Tecnomobele-FGA/Computador-de-bordo/README.md

# OBC - Computador de bordo 

`Documentos/GitHub/Computador-de-bordo`

[github.com/Tecnomobele-FGA/Computador-de-bordo](https://github.com/Tecnomobele-FGA/Computador-de-bordo)

# 1. Apresentação

Escolheu-se para o computador de bordo do BRElétrico o minicomputador *Beagle Bone*. A sua escolha se baseou no fato de ter uma arquitetura apropriado para sistemas embarcadas baseado em num ARM, ter além do processador principal, dois *Programmable Real-time Unit (PRU)* que podem ser usados para alguma necessidade de processamento dedicado e dois controladores CAN já incorporados na sua placa.

Há diversas versões do Beagle Bone. Um dos mais populares é o *Beagle Bone Black (BBB)* que foi a primeira versão usado neste desenvolvimento.

BBB tem uma interface HDMI, porta ethernet, porta USB e já vem com Linux embarcada e toda estrutura de software para habilita-lo como servidor com toda funcionalidade TCP-IP internet inerente do Linux. 

A figura a seguir mostra o diagrama do bloco do computador de bordo com display HDMI no painel do veículo e as redes  CAN ligado aos módulos. 

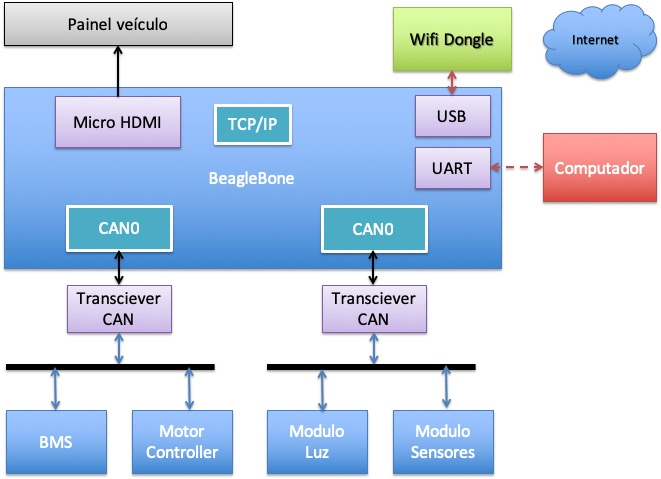
[picture p1: figuras/Diagrama_BBB_can.jpg]


Entretanto, há uma versão mais nova que foi lançada recentemente que é mais compacto (e barato). O PocketBeagle, tem toda a funcionalidade do BBB, mas diversos conectores físicos dos interfaces da BBB foram retiradas e também foi retidada a interface HDMI. 

```
$uname -a
Linux beaglebone 4.19.94-ti-r50 #1buster SMP PREEMPT Mon Aug 24 23:03:55 UTC 2020 armv7l GNU/Linux
```

Para implementar a proposta foi necessário ligar um transciever CAN para  adequar os sinais cmos do Beagle ao padrão do barramento CAN. Este módulo é alimentado com 3.3V podendo ser diretamente ligado no barramento de expansão do Beagle.

O Beagle funcionará como ponte entre as duas redes CAN e a rede TCP-IP. A partir da rede TCP-IP pode-se ter acesso ao Beagle permitindo a sua monitoração remoto ou re-programação.

A primeira rede Can (Can0) estará ligado aos subsistemas críticos do veículo elétrica, fazendo o monitoramento do banco do bateria, o motor de tração e outros subsistemas que precisam comunicar entre se neste barramento mas rápido. 

A segunda rede (Can1) permitirá a comunicação entre o modulo de medição de velocidade e temperatura, o módulo de sinalização e luzes e demais módulos que não são críticos ao funcionamento do veículo. A comunicação destes útimo barramento pode ter uma velocidade menor que o primeiro.

A implementação deste sistema foi feito com um PocketBeagle e um modulo conversor CAN baseado no transciever SN65HVD230, conforme mostrado na foto a seguir:

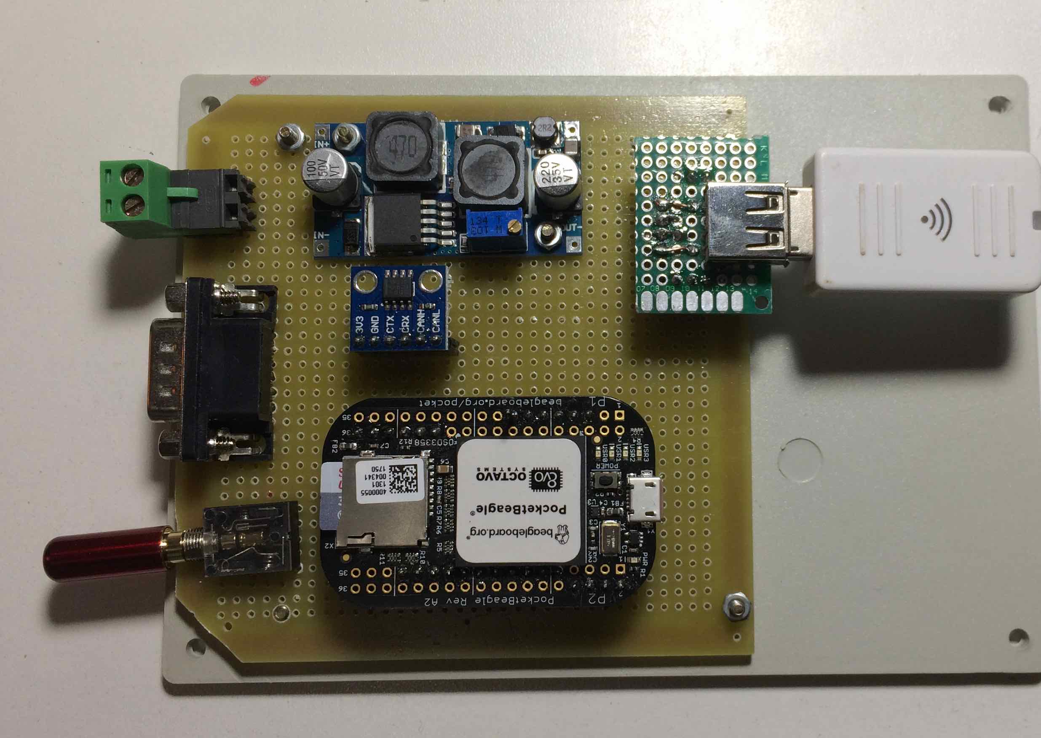
[picture p2: fotos/pocketbeagle_can.jpg]


O Pocket Beagle foi montado numa placa com transciever CAN, conversor CC/CC 12/5 volts, Wifi USB Dongle, e acesso para o serial UART.  

A tabela a seguir mostra a proposta de uso dos periféricos do Pocket Beagle. 

| Beagle  | uso | pinos | Situação |
|:---:|:---:|:-----:|:---:|
| CAN 0 | Barramento CAN  | P1 - 26, 28 | Implementado |
| CAN 1 | ainda nao ligado fisicamente  | P2 - 9,8 | Ainda não |
| USB | WiFi Dongle | P1 - 5,7,9,11,13,15 | Implementado |
| UART 0  | Acesso ao Beagle pelo serial com terminal | P1 - 30, 32 | Implementado |
| UART 2  | GSM SIM800L | P1 - 8,10,12 | Ainda não |
| UART 4  | Serial GPS | P2 - 5,7 | implementado |
| Battery | Litium 18650 | P2 - 14,16 | Implementado | 
| GPIO | Chaves para GND | P2 - 2,4 | Montada | 

# 2. Configurando o PocketBeagle

## 2.1 Acessando o PocketBealge

O primeiro passo é configurar o hardware do PocketBeagle para a proposta.

Os pinos no barramento de acesso do PocketBeagle podem ser configurados para dar acesso a várias funcionalidades do computador. 

A dificuldade consiste no fato de o Beagle ter um sistemática de mapeamento de hardware no sistema operacional Linux específica, diferente dos computadores convencionais. O Beagle é um computador numa única placa que usa o processador com arquitetura ARM. Por conta dos inúmeros sistemas baseados no arquitetura ARM que surgiram para sistemas embarcadas, houve uma modificação no Kernel do Linux para dar conta a especificidades destes sistemas.

### 2.1.1 Acessando o Beagle pelo Serial UART

Uma maneira simples de acessar o Beagle sem ter que usar monitor teclado ou rede é pela porta UART0 do Beagle.
Essa porta já vem habilitado para você entrar por meio de um programa emulador de terminal. 
Os pinos do Pocket Beagle que permitem este acesso são dados na tabela a seguir. 

| Beagle  | con | pino | UART | pino |
|:---:|:---:|:----:|:----:|:----:|
| gnd | P1  | 16 | GND  | |
| tx uart0| P1  | 30 | rx | |
| rx uart0| P2  | 32 | tx | |

O nível de tensão do UART é de 3.3 volts, e pode se acessar com um conversor USB- Serial TTL. 

O programa de emulador de terminal tem que estar configurado com a porta serial em 115kbps, 8N1.

A foto a seguir mostra o conversor SERIAL USB-TTL que foi usado para ligar o Beagle a porta USB de computador para ter acesso via terminal ao Beagle.
 
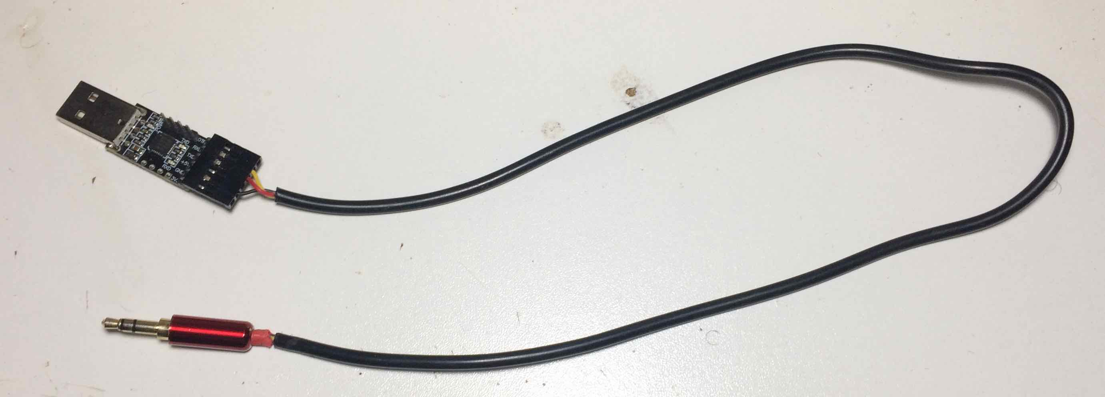
[picture p3: fotos/Serial_interface.jpg]


### 2.1.2 Acessando o Beagle pelo USB ou pela rede

O PocketBeagle pode ser accessado na USB pelo comando:
 
`ssh debian@192.168.6.2`  ou `ssh debian@beaglebone.local` 

e a senha padrão do Beagle é `temppwd` 

### 2.1.3 Configurado Cloud9 IDE 
Uma opção de acessar o Beagle é usando o Cloud9 IDE. Essa opção é habilitado quando ligar o Beagel pela porta USB ao computador, e pode ser acessado por meio de um browser pelo endereço `http://192.162.6.2 do computador (mac os ou linux).

A interface do Cloud9 é muito bom e tem diversos programas exemplos direcionado para o Beagle. 

Uma limitação é que ele aponto para o endereço `/var/lib/clouds` e não para a nossa area de trabalho no Debian.

Para mudar isso tem um tutorial no [link](https://paulbupejr.com/change-cloud9-workspace/)

O procedimento consiste em criar um override do `systemctl edit cloud9` e colocar no novo arquivo criado o seguinte conteudo 

```
[Service]
ExecStart=
ExecStart=/usr/bin/nodejs server.js --packed -w /home/debian/src
```

Depois precisa reiniciar o servico 

```
systemctl daemon-reload
systemctl restart cloud9
```

Ao acessar o IDE do Cloud9 no browser terá como diretório atual o 
```
/home/debian/src
```

## 2.2 Configurando a interface CAN

No sistema operacional Linux  convencional as especificidades do hardware são de certa forma incorporadas no Kernel, mas este sistemática se mostrou impraticável com as placas ARM. Por isso foi introduzido a estrutura de Device Tree para que o computador Beagle saiba qual hardware e periféricos estão fisicamente instalados na placa. Veja o artigo de Mateus Gagliardi: Introdução ao uso de Device Tree e Device Tree Overlay em Sistemas Linux Embarcado. 2015. <https://www.embarcados.com.br/device-tree-linux-embarcado/>

No caso do Beagle essa estrutura de Device Tree tem que dar conta para definir quais pinos serão usados do hardware, pois Beagle tem portas genéricas para entrada e saída de dados (GPIO), uma porta analógica (ADC), PWM, UART, SPI e I2C pinos, e estes pinos podem ser configurados para diversos usos. No nosso caso específico, as duas controladoras CAN usam alguns dos pinos da SPI e do I2C como entrada e saída dos sinais CAN. 

Este roteiro é uma adaptação da configuração do BBB no artigo no [https://www.beyondlogic.org/adding-can-to-the-beaglebone-black/](https://www.beyondlogic.org/adding-can-to-the-beaglebone-black/) para o PocketBeagle.

Nos releases dos kernels mais novos a configuração do pinos é melhor documentos. Para ver a versão do kernal pode executar o comando: 

`$ uname --a`

```
Linux beaglebone 4.19.94-ti-r42 #1buster SMP PREEMPT Tue Mar 31 19:38:29 UTC 2020 armv7l GNU/Linux
```

Para verificar se de fato a Can bus está mapeado no kernel pode-se executar o comando 
`$ dmesg | grep can`

A resposta tem que ser algo do tipo: 

```
[    1.047544] c_can_platform 481cc000.can: c_can_platform device registered (regs=5e6dc592, irq=39)
[    1.049113] c_can_platform 481d0000.can: c_can_platform device registered (regs=e2b987c8, irq=40)
[    1.186345] can: controller area network core (rev 20170425 abi 9)
```

O próximo passo é configur as duas portas can0 e can1. 
A figura a seguir mostra os conectores P1 e P2 com as diversas opções dos pinos.

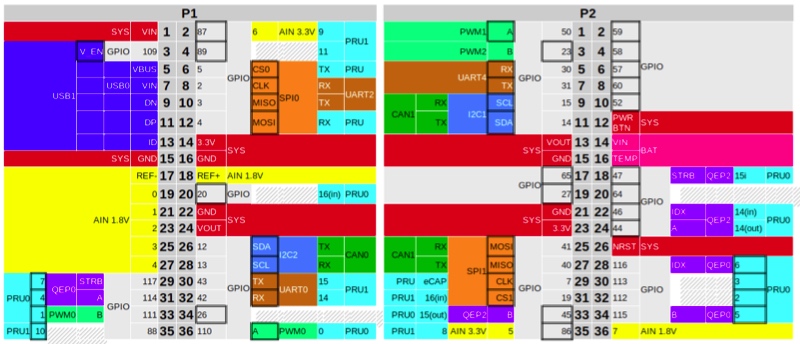
[picture p4: figuras/conector_pocket.jpg]


A interface CAN0 pode ser ligado nos pino 26 e 28 do conector P1. 
Nota-se que a interface CAN1 pode ser ligado nos pinos 9,10 ou 25,27.
Escolheu-se ligar os pinos 26 e 28 do P1 para can0 e 26 e 27 do P2 para can1

| Beagle  | con | pino | transciever | pino |
|:---:|:---:|:----:|:---:|:----:|
| gnd | P2  | 21 | GND | 2 |
| 3.3v | P2  | 23 | 3V3 | 1 | 
| can1 rx | P2  | 25 | CRX | U1-4 |
| can1 tx | P2  | 27 | CTX | U1-3 |
| can0 tx | P1  | 26 | CTX | U2-3 |
| can0 rx | P1  | 28 | CRX | U2-4 | 

Há um programa de configuração de pinos que permite escolher a funcionalidade do pino e ver seu atual uso.
Por exemplo o seguinte comando lista todas as opções disponíveis para o pino P2.5:
 
`config-pin -l P2.25`

```
Available modes for P2_25 are: default gpio gpio_pu gpio_pd gpio_input spi spi_cs uart can i2c
``` 

Para configurar o pino para acessar a interface can:

`config-pin P2.27 can`

Para finalizar o processe de configuração do hardware temos que iniciar a interface CAN com o seguinte comando: 

` sudo /sbin/ip link set can1 up type can bitrate 500000`

Com isso pode se verificar o status da interface can com os comandos normais de rede do linux que deve mostrar a nova interface can e todos os outros interfaces de comunicação do sistema.

`ifconfig`

Para automatizar o processo de ativação do Can bus no boot ainda falta descobrir como configurar os pinos como interface can durante o boot. 
Uma opção é de colocar dentro do `crontab` uma sequencia de scripts que serão executados durante o boot.  

script de configuração do CAN no arquivo `code/can0_can1_start.sh`

```
#!/bin/bash
echo "Iniciando as configuracoeas dos pinos para a rede CAN..."

config-pin P1.26 can
config-pin P1.28 can
sudo /sbin/ip link set can0 up type can bitrate 250000

config-pin P2.25 can
config-pin P2.27 can
sudo /sbin/ip link set can1 up type can bitrate 250000

echo "Pinos de CAN0 e CAN1 configurados!..."
```

Com isso conseguimos resolver a parte mais difícil até o presente momento que foi a configuração do Beagle para ativar os dois controladores CAN, habilitar o hardware de interfaceamento com os transcievers CAN e configurar a porta de comunicação no linux para conversar com os controladores.

Para testar se os canais CAN estão funcionando, pode fazer o teste com o loopback 
`sudo /sbin/ip link set can0 up type can bitrate 250000 loopback on`

### 2.2.1 Ligando CAN no DB9

Tem dois padrões de ligação do conector CAN no DB9. 
Um padrão é compativel com a placa Arduino CAN Shield da Sparkfun e o cabo DB9-OBDII que a acompanha.

O Cabo tem a seguinte pinagem  OBDII para DB9 Femea.

| Pin Description | OBDII | DB9 |
|:---|:-----:|:---:|
| J1850 BUS+ |  2 | 7 |
| Chassis Ground |  4 | 2 |
| Signal Ground |  5 | 1 |
| CAN High J-2284 |  6 | 3 |
| ISO 9141-2 K Line	|  7 | 4 |
| J1850 BUS- | 10 | 6 |
| CAN Low J-2284 | 14 | 5 |
| ISO 9141-2 L Line	| 15 | 8 |
| Battery Power | 16 | 9 |

[https://www.sparkfun.com/products/10087](https://www.sparkfun.com/products/10087)

Tem que ter cuidado de não ligar o DB9 para uma porta serial RS232 convencional, pois os pinos de GND e TX e RX com tensão +de 12 e -12v vão diratemente no transciever. 

Há um outro padrão de pinagem CAN para DB9, mas eu ainda não descobri de onde que vem esta definição.

Vamos usar este padrão novo, pois o cabo OBDII-DB9 a gente dificilmente vai usar no carro elétrico.

Dessa forma o conector CAN do Beagle com um DB9 macho terá os seguintes pinos: 

| Transciever | DB9 | 
|:---:|:---:|
| CANL | 2 |
| CANH | 7 | 
| GND | 3 |

### 2.2.2 Testando com can-utils

O sistema operacional Linux embarcada no BBB já vem com pacote SocketCan ou can-utils de ferramentas para trabalhar com a rede de comunicação CAN.
 
Este pacote de ferramentas e utilitários permite visualizar, registrar e gerar tráfego de dados do barramento CAN, além de permitir acesso ao barramento CAN via IP sockets entre vários outros funcionalidades. <https://github.com/linux-can/can-utils>

O utiltário candump do SocketCan permite visualizar os dados do barramento de comunicação.

Com o programa cangen é possivel gerar uma saída aleatorio numa porta can. 
Para testar a rede can executa num terminal :

```
debian@beaglebone:~$ cangen can0
```

Num outro terminal executa 

```
debian@beaglebone:~$ candump any -x 
  can0  RX - -  6B9   [8]  EB 3F 68 35 C9 1B DE 56
  can1  TX - -  6B9   [8]  EB 3F 68 35 C9 1B DE 56
  can0  RX - -  37A   [8]  76 4A DF 7A 42 74 85 5C
  can1  TX - -  37A   [8]  76 4A DF 7A 42 74 85 5C
  can0  RX - -  0EA   [1]  DF
  can1  TX - -  0EA   [1]  DF
  can0  RX - -  69D   [8]  0F E2 C0 10 A8 34 8E 2B
  can1  TX - -  69D   [8]  0F E2 C0 10 A8 34 8E 2B
  can0  RX - -  5EF   [1]  1D
  can1  TX - -  5EF   [1]  1D
```

Há uma vasta documentação técnica sobre o uso do SocketCan em sistemas operacionais Linux acessando a porta CAN a partir de programas desenvolvido em C/C++ ou Python.

## 2.3. Ligando wifi no Beagle

Para facilitar o desenvolvimento no Pocket Beagle é necessário colocar o Beagle diretamente na internet sem usar a porta USB do computador hospedeiro. 

Para configurar o WiFi Dongle foi usado o `connmanctl` conforme mostrado na figura a seguir.

| Beagle  | con | pino | USB | pino |
|:---:|:---:|:----:|:---:|:----:|
| Vbus | P1  | 5 | Vcc | 1 |
| Vin | P1  | 7 | Vcc | 1 | 
| DN | P1  | 9 | | 2 |
| DP | P1  | 11 | | 3 |
| ID | P1  | 13 | GND | 4 |
| GND | P1  | 15 | GND | 4 |

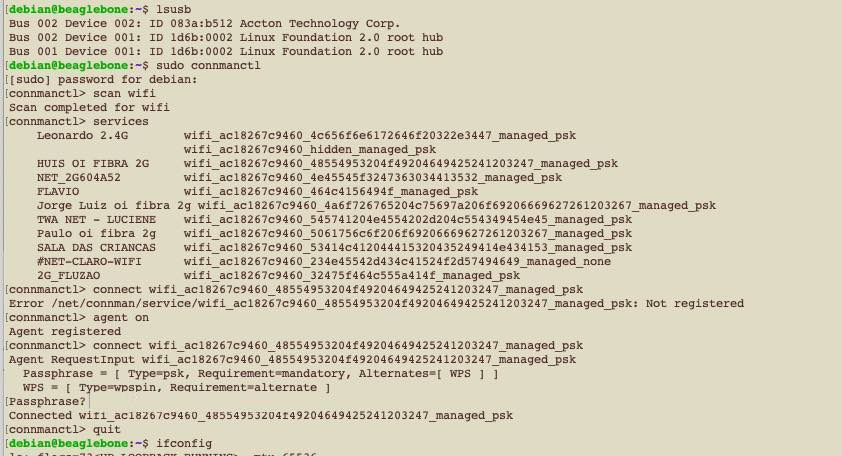
[picture p5: figuras/Beagle_wifi_config.jpg]


O funcionamento do USB WiFi Dongle ficou meio devagar com o tempo. 
Quando logo pelo ssh ele demora alguns segundos para processar os comandos. 
Não sei se foi a inclusão de outras portas seriais ou se há a necessidade de desligar as outras portas USB.

Aparentemente o WiFi dongle está esquentando além do normal. Pode ser um problema neste modelo de dongle que está dos antigos.

### 2.3.1. Endereço IP fixo no wifi
Para manter um IP fixo no beagle podemos configurar por meio do `connmanctl` a configuração da rede wifi. 
Na distribuição DEBIAN que estamos usando não temos os arquivos de configuração da rede na pasta `/etc/wpa_supplicant/` como a gente encontre no Raspberry Zero com sua distribuição linux.

No Beagle com Debian, aparentemente as configuracoes estão nos diretórios na pasta `/var/lib/connman/`. 
Cada diretório corresponde a uma das configurações dos wifi já usados no sistema. Neste diretório há o arquivo `settings` com a configuração.

Achie num tutorial na internet uma maneira para configurar este arquivo `settings` para ter um IP Fixo. 

```
IPv4.method=manual                ←Method to be used (in this case manual IP)
IPv4.netmask_prefixlen=24
IPv4.local_address=192.168.0.133  ←Desired IP address
IPv4.gateway=192.168.0.1
Passphrase=<PASS>                 ←Wifi network password
AutoConnect=true
```

Eu ainda não testei, mas vale a pena depois testa-lo e tirar a dificuldade de adivinhar cada vez o endereço IP. 
Entretanto, deve ter uma maneira de fazer isso diretamento usando o `connmanctl`.

## 2.4. Módulo GPS Ublox 7

O módulo GPS tem as seguintes características.

* Alimentação: de 3,3 V à 5 V DC
* Corrente de operação: entre 35 mA e 50 mA
* Comunicação serial/TTL 3.3V
* Antena embutida

| Pino | 	Função no GPS | Ligação Beagle |
|:----:|:---:|:---:|
| 1	 | Vcc | Vcc |
| 2	 | GND | GND |
| 3	| TX out | RX4 pino P2-05 |
| 4	| RX in  | TX4 pino P2-07 |

Detalhamento da comunicação. O formato do Protocolo de comunicação NMEA0183.

* Cada início de mensagem começa com o símbolo cifrão(\$).
* Os próximos 5 caracteres indicam a origem da mensagem, sendo dois para a origem e três para o tipo de mensagem.
* Todos os campos dos dados são delimitados por vírgulas.
* O primeiro caractere do último campo deve ser um asterisco (*).
* O asterisco é seguido de um checksum de dois dígitos em hexadecimal
* A mensagem é terminada com um Nova Linha ( <CR><LF> ou "\n" ).

A figura a seguir mostro o módulo GPS ligado no computador de bordo.

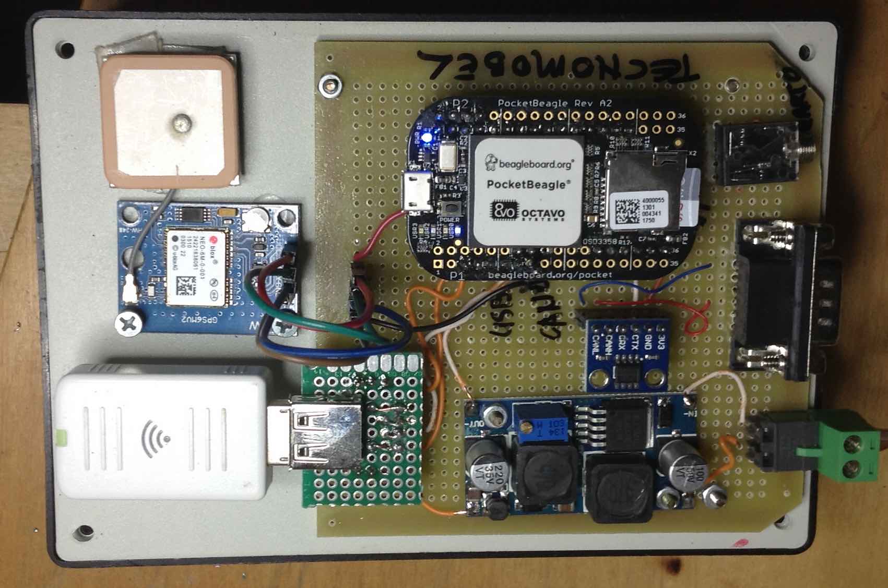
[picture p6: fotos/modulo_GPS.jpg]


Este módulo foi ligado a porta Serial UART 4 do Pocket Beagle.
Para verificar se as portas serias estão devidamente instaladas e habilitados na versão do sistema operacional do Pocket Beagle, podemos verificar isso com o seguinte comando:

```
debian@beaglebone:~$ dmesg | grep tty
[    0.000000] Kernel command line: console=ttyO0,115200n8 root=/dev/mmcblk0p1 ro rootfstype=ext4 rootwait coherent_pool=1M net.ifnames=0 lpj=1990656 rng_core.default_quality=100 quiet
[    0.001786] WARNING: Your 'console=ttyO0' has been replaced by 'ttyS0'
[    1.201568] 44e09000.serial: ttyS0 at MMIO 0x44e09000 (irq = 30, base_baud = 3000000) is a 8250
[    1.211685] console [ttyS0] enabled
[    1.212940] 48022000.serial: ttyS1 at MMIO 0x48022000 (irq = 31, base_baud = 3000000) is a 8250
[    1.213937] 48024000.serial: ttyS2 at MMIO 0x48024000 (irq = 32, base_baud = 3000000) is a 8250
[    1.214879] 481a8000.serial: ttyS4 at MMIO 0x481a8000 (irq = 33, base_baud = 3000000) is a 8250
debian@beaglebone:~$ 
```

Conforme a listagem podemos confirmar que a porta ttyS4 está instalada nessa versão do software. 
Entretanto é necessária habiltar os pinos do UART 4 do PocketBeagle por meio do comando config-pin

```
debian@beaglebone:~$ config-pin -l P2_05

Available modes for P2_05 are: default gpio gpio_pu gpio_pd gpio_input uart
debian@beaglebone:~$ config-pin P2_05 uart
debian@beaglebone:~$ config-pin P2_07 uart

```

Para testar se o GPS está comunicando com o PocketBeagle pode-se usar por exemplo o programa Minicom, configura-lo para ttyS4, 9600 bps, 8N1, e dessa forma deve aparecer a seguinte tela, onde a cada segundo a informação do GPS é atualizada. 

```
Welcome to minicom 2.7.1

OPTIONS: I18n 
Compiled on May  6 2018, 10:36:56.
Port /dev/ttyS4, 12:19:54

Press CTRL-A Z for help on special keys

$GPRMC,,V,,,,,,,,,,N*53
$GPVTG,,,,,,,,,N*30
$GPGGA,,,,,,0,00,99.99,,,,,,*48
$GPGSA,A,1,,,,,,,,,,,,,99.99,99.99,99.99*30
$GPGSV,1,1,01,05,,,23*7C
$GPGLL,,,,,,V,N*64
$GPRMC,,V,,,,,,,,,,N*53
$GPVTG,,,,,,,,,N*30
$GPGGA,,,,,,0,00,99.99,,,,,,*48
$GPGSA,A,1,,,,,,,,,,,,,99.99,99.99,99.99*30
$GPGSV,1,1,02,05,,,23,06,,,24*7F

```
### 2.4.1 Datalogger para registrar rota 
O programa para registra os dados do GPS e (ou a rota ou percurso) do veículo a uma amostragem de 1 hz está no [subdiretório deste repositório](./Datalogger_Scada/README.md).

## 2.5. GSM SIM800L  

Módulo GPRS GSM SIM800L 

Especificações:

* CI SIM800L;
* Frequências: EGSM900, DCS1800, GSM850, PCS1900;
* GPRS Data Downlink: 85.6 kbps (máximo);
* GPRS Data Uplink: 85.6 kbps (máximo);
* Suporte PAP (password authentication protocol) para conexões PPP;
* Protocolo TCP/IP embutido;
* Serial: 1200 bps à 115.200 bps;
* Temperatura de operação: -40 à 85°C;
* Dimensões: 21 x 15 x 3,2mm.

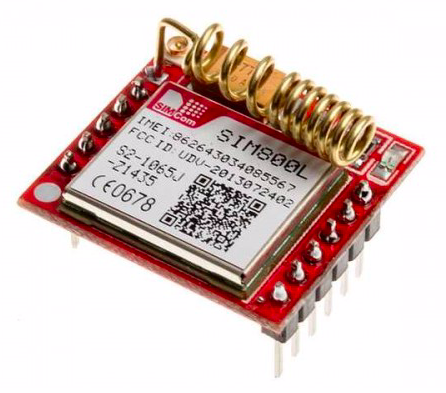
[picture p7: fotos/GSM_sim80L.png]


| Pino | 	Nome do Pino |Função | Ligação Beagle | Pino |
|:----:|:---:|:---:|:---:|:----|
| 1 | Vcc | Alimentação 3.3v  | 3.3V do LM317 | null |
| 2	 | RST | Reset | GPIO | P1-12 |
| 3	 | RxD | Entrada - receptor uart  | TxD UART 2 |P1-08|
| 4	 | TxD | Saída - transmissor uart | RxD UART 2 |P1-10|
| 5	 | GND | comun  | GND | GND |

Configurando os pinos do Pocket Beagle para habilitar UART 2 usando 

```
$ config-pin -l P1.08
$ config-pin P1.08 uart
$ config-pin P1.10 uart
```

[datasheet do SIM800L](https://cdn.awsli.com.br/78/78150/arquivos/sim800l-datasheet.pdf)

Os comandos AT para usar o GPRS para mandar dados via internet são:

[exemplo no tutorial](https://www.youtube.com/watch?v=7GtfhTVDIc0)

```
AT+SAPBR=3,1,"APN","CMNET"
AT+SAPBR=1,1
AT+SAPBR=2,1
AT+HTTPINIT
AT+HTTPPARA="CID",1
AT+HTTPPARA="URL","http://164.41.92.20:8080/ScadaBR/httpds?bat_litium_ups=3.7"
AT+HTTPACTION=0
AT+HTTPREAD
AT+HTTPTERM
AT+SAPBR=0,1

```

A primeira vez quando mandou o comando o servidor ScadaBR recebeu os dados e consegui mostrar o valor encaminhado. 
Na segunda vez deu o servidor retornou um erro 601. Falta analisar todos os comandos AT do GPRS e avaliar essa funcionalidade do modem.

## 2.6. Bateria Litium 18650

O Pocket Beagle tem um circuito de carga linear e gerenciamento de bateria de integrado. O *Linear charge and power path management system* do Pocket Beagle é baseado no por um circuito de alimentação da bateria, um sensor de temperatura que permite a entrada de um termistor de 10K e o circuito está integrada com o botão de reset do pocket beagle.

A bateria Litium 18650 foi ligado aos pinos P2.14 e GND junto com um resistor no pino P2.16  e GND para simular a função do termistor. 

Não houve a necessadade de configuração específico da função de UPS. O funcionamento é automática. 

Essa bateria de 3.800 mAh é capaz de segurar o funcionameno do Beagle durante algumas horas.

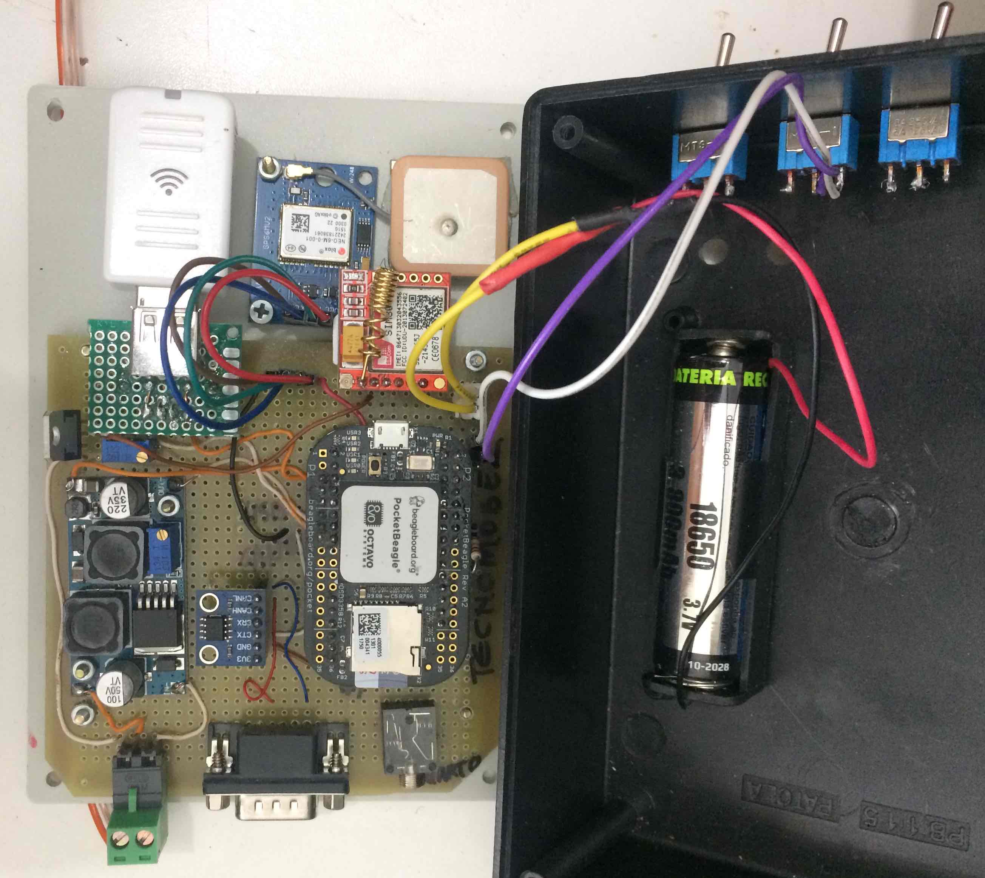
[picture p8: fotos/OBC_completo.jpg]


A entrada de P2.14 permite uma tensão de entrada de 3,7V de uma bateria Litium e o Pocket Beagle gera internamente 3.3 V para seu funcionamento. 

As saidas 3.3V do Pocket também são alimentados, então por exemplo os módulos GPS e CAN funcionam normalmente com essa bateria.

Quando o OBC está sendo alimentado com 5V, o bateria é carregada automáticamente e quando a tensão de 5V é retirada a bateria assume automaticamente a alimentação do Pocket Beagle. 

Para desligar o OBC deve-se então apertar o botão de reset. 

Quando se liga o o Pocket Beagle à bateria, o sistema só inicia o boot quando apertar o botão de reset. 

Deve ter alguma funcionalidade de monitorar a tensão da bateria já embutido no Linux, mas eu ainda não descobri os detalhes do seu acesso e funcionamento.

## 2.7. Display OLED 

Para facilitar a inspecção de funcionamento do Beagle foi colocado um display Oled de 128x32 SSD1306. 
Como este display tem uma interface i2c e é alimentado com 3.3Volts a montagem pode ser diretamente na porta i2c 1 do Beagle (Testamos com o pocket beagle - falta testar no BBB).

A foto a seguir mostra a montagem.

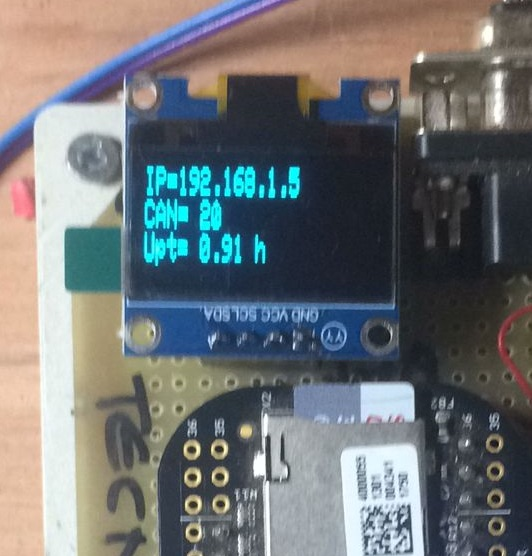
[picture p9: fotos/Foto_Oled.jpg]
 

Para configurar os pinos do i2c configuramos os mesmos como o aplicativa config-pin conforme mostrada a seguir.

```
$ config-pin P2.09 i2c
$ config-pin P2.11 i2c
```

O programa para ler o endereço IP e mostrar no display em python é:

```
from board import SCL, SDA
import busio
import adafruit_ssd1306
import netifaces

font='/home/debian/src/Oled/font5x8.bin'

i2c = busio.I2C(SCL, SDA)
display = adafruit_ssd1306.SSD1306_I2C(128, 32, i2c)

display.fill(0)
display.show()
display.rotate(180)

lista=netifaces.interfaces()
if 'wlan0' not in lista:
     display.text("IP= sem wlan0",1, 1, 1,  font_name=font, size=1)
else: 
     ad=netifaces.ifaddresses('wlan0')
     xx=ad[netifaces.AF_INET]
     d=xx[0]
     ip=d['addr']
     display.text("IP="+ip,1, 1, 1,  font_name=font, size=1)

```

O arquivo com o fonte `fontxx8.bin` achei depois de uma busca na internet.
 
O desafio agora é fazer com que este programa em python seja chamada no boot para mostrar o endereço internet atualizada.

Tentamos fazer isso com `crontab`, mas não funcionou de forma satisfatório. Pesquisamos e descartamos também a opção de usar o `init.d` e vamos agora testar com `systemd` baseado nestes links 

[https://tecadmin.net/setup-autorun-python-script-using-systemd/](https://tecadmin.net/setup-autorun-python-script-using-systemd/)

[https://blog.merzlabs.com/posts/python-autostart-systemd/](https://blog.merzlabs.com/posts/python-autostart-systemd/)

Quando criamos um service no `/lib/systemd/system/oled.services` e chamamos o script em python surgiu um problema na importação do python com `import adafruit_ssd1306` 
O script em python funcionou normalmente, mas a sua chamada pelo `systemctl` deu este erro. 

Essa falha foi resolvido colocando no `oled.service` o usuário e grupo.

```
debian@beaglebone:~$ cat /lib/systemd/system/oled.service 
[Unit]
Description=Oled_Display
After=multi-user.target

[Service]
Type=simple
ExecStart=/usr/bin/python3 /home/debian/src/Oled/oled.py
User=debian
Group=debian

[Install]
WantedBy=multi-user.target

```

# 3. Comunicação no barramento CAN - Camadas superiores

O computador de bordo tem que monitorar o controlador do motor elétrico e o BMS no barramento CAN de alta prioridade (velocidade).

O computador de bordo (OBC) tem que ser flexivel o bastante para se comunicar com diversos modelos de controladores de motores elétricos e BMS.  

No caso do BRElétrico, temos um motor de CC brushless do fabricante Guandong que tem uma interface CAN. A documentação deste controlador e motor não é dos melhores, mas pelo menos temos a especificação do protocolo CAN usado pelo controlador e indica que usa o protocolo J1939 nas camadas superiorers.

No projeto da conversão da VAN vamos usar o CVW500 da WEG que também tem uma interface CAN e implementa o protocolo CANOPEN.

Vamos implementar os dois protocolos e testar. O J1939 vai ser implementado para o BREletrico e o CANOPEN para a VAN. 
O J1939 tem a vantagem de ser específico para aplicações de mobilidade. 

## 3.1. Protocolo J1939

O protocolo J1939 em termos gerais define as mensagens que vão transitar no barramento, para onde eles vão, as prioridades das mensagens e frequencia com que determinadas mensagens são disponibilizados no barramento.

Dessa foram, o computador de bordo só precisa monitorar o barramento e usar as mensagens que lhe interessa para tomar determinada ação e colocar mensagens com as suas demandas ou ações no barramento de volta. 

Por exemplo: O protocolo J1939 implementado pelo controlador do motor elétrico manda a cada 40ms informação com a tensão e corrente do motor. O BMS manda também em tempos regulares o estado da bateria, indicando quanto de energia ainda tem disponível. O módulo de instrumentação manda a cada 100ms a informação da velocidade do veículo. Com estes dados, o OBC computador de bordo pode calcular por exemplo qual automia em Km, mantendo o mesmo padrão de direção e mostrar essa informação para o condutor.

### 3.1.1. Estrutura do J1939

O J1939 aproveita o identificador do 29 bits do CAN para passar informações específicas do tipo de comunicação. 

A estrutura de bits da identificação tem o seguinte formato.

| priority | Extendes data page | data page | PDU Format | PDU Specific | source adddres |
|:---:|:-----:|:----:|---|---|---|
| 3 bits | 1 bit | 1bit | 8 bits | 8 bits | 8 bits |

Os campos PDU Format e PDU Specific construem o valor que será atribuído ao Parameter Group Number PGN da mensagem e também definem o modo como as mensagens são endereçadas no barramento.

| PDU Format | descriçao | PDU Specific | 
|:-----:|:----:|:---:|
| 0-0xEF ou 0-239 | transmite para endereco indicado no PDU specific | endereco|
| 0xF0-0xFF ou 240-255 | broadcast | Indice de referencia do Group Extension |  

A formatação do PGN é (PDU format) * 0x100 + PDU specific  

## 3.2. Controlador Motor PM BLDC Guandong

Os parametros do Controlador do motor Brushless CC PM BLDC Guandong são mandados por um CAN frame com as seguintes especificações. O fabricante menciona que os protocolos usados são CAN20.0 e J1939

Bus rate: 250kbps

A taxa de envio é 40 ms mandando 2 mensagens, ou seja uma mensagem a cada 20 ms.
 
O protocolo usa CAN 2.0 com CAN expand frame 29th identifier

A primeira mensagem (*frame*) frame ID code é `0x10 08 8A 9E.` ou `268.995.230`.
Isso é uma mensagem que vai de `8A` para `9E`, pois o campo PDU format `08` é menor que `EF`. Ou seja, o endereço do controlador é `9E`. 

O dados encaminhados na mensagem são os seguintes:

| Location | data name |  explain |
|:---:|:---:|:---:|
| BYTE1 | voltage low byte | 0.1 V/bit offset: -10000 range: 0~500v (o offset tá meio estranho )|
| BYTE2 | voltage high byte |
| BYTE3 | currente low byte | 0.1 A/bit offset: -10000 range -500A~500A |
| BYTE4 | currente high byte  |
| BYTE5 | controller temperature | 1℃/bit offset: 40C limit: 0~100℃ |
| BYTE6 | running state |
| BYTE7 | fault code low byte  |
| BYTE8 | fault code high byte |

O BYTE 6 com o Running status tem o seguinte formato: 

| BIT7 | BIT6 | BIT5 | BIT4 | BIT3 | BIT2 | BIT1 | BIT0 | 
|:----:|:----:|:----:|:----:|:----:|:----:|:----:|:----:|
| reserved | ready for | reserved | reserved | stop | brake | backward | forward|

O código de erro nos BYTES 7 e 8 (*Fault code instruction*) tem os seguintes formatos 

| BIT7 | BIT6 | BIT5 | BIT4 | BIT3 | BIT2 | BIT1 | BIT0 | 
|:----:|:----:|:----:|:----:|:----:|:----:|:----:|:----:|
| 0 | ERR7| ERR6 | ERR5 | ERR4 | ERR3 | ERR2 | ERR1 |
| 75℃ | BMS | over speed | over heating | over voltage | under voltage | over current | IGBT |

A segunda mensagem (*frame ID code*) tem como código de identificação de `0x10 09 8A 9E`  ou `269.060.766`. 
Os dados mostram a operação do motor da seguinte maneira:

| DATA LOCATION | DATA NAME | explain |
|---|---|---|
| BYTE1 | motor speed low byte | 1rpm,  offset： 0, range：0 ～10000 |
| BYTE2 | motor speed high byte | |
| BYTE3 | mileage low byte	| 0.1	kilometer, offset：0, range：0～30000| 
|BYTE4	| mileage high byte |	
|BYTE5	| motor torque low byte	 | 0.1NM, offset：-10000, range：-1000～1000 (o valor do offset é estranho .....) |
|BYTE6	| motor torque high byte |
|BYTE7	| reserved|	
|BYTE8	| reserved|
	
```
0x10088A9E = PDU format 0x08, specific 0x8A, PGN = 2186, source adress = 0x9E
0x10098A9E = PDU format 0x09, specific 0x8A, PGN = 2442, source adress = 0x9E
```

Para facilitar o desenvolvimento do OBC fizemos uma programa de simulação da comunicação do controlador PM BLDC Guandong em python com a biblioteca Python CAN [https://python-can.readthedocs.io/en/master/](https://python-can.readthedocs.io/en/master/)

O programa está no diretório:

`code_simulador_motor/simulador_motor.py`

O simulador gera as seguintes mensagens no barramento a cada 20ms, conforme especificado no datasheet do fabricante.

```
debian@beaglebone:~/src$ candump can1
  can1  10088A9E   [8]  C4 09 E8 03 28 41 00 40
  can1  10098A9E   [8]  E8 03 D0 07 78 00 FF FF
  can1  10088A9E   [8]  C4 09 E8 03 28 41 00 40
  can1  10098A9E   [8]  E8 03 D0 07 78 00 FF FF 
```
para os parametros
 
```
run.stop=0
run.forward=1
run.readyfor=1
fault.bms=1
voltage= 250 V
current= 100 A
temperature= 40 oC
rpm = 1000 rpm
mileage = 2000 km
torque =  120 Nm
```

O programa de simulação do motor PM da Guandong foi feito de forma codificando diretamente os valores num frame CAN.
Este método funciona quando é um sistema com muito poucos nós e poucas mensagens.
Na medida que os sistemas incorporam mais ECUs no barramento vai ser necessário usar ferramentas específicas para analisar e acompanhar o trafego na rede. 

O protocolo J1939 especifica as camadas as camada de rede e as camadas superiores do modelo OSI. 
A camada de rede tem a necessidade de, em primeiro lugar, definir o sistema de endereçamento da rede e garantir a entrega dos pacotes ou mensagens para os endereçados.

Assim os ECUs numa rede CAN devem ter pelo menos um endereço para poder encaminhar as mensagens. 
O protocolo J1939 define que os ECUs devem ter pelo menos um endereço físico e um nome. 
Entretanto, um ECUs pode controlar mais endereços e nomes. 
A função do endereço é definir o destino ou a origem da mensagem, enquanto o nome inclua uma indicação da funcionalidade do ECU no endereço.

A identificação do frame no caso do Controlador do Motor Guandong é `0x10 08 8A 9E` e `0x10 09 8A 9E`. 
Essas identificações são formados por 29 bits ou 4 bytes (32 bits - 3 bits). 

O últime byte é o endereço de origem, que neste caso é 0x9E.
Em seguida vem dois bytes que formam o Parameter Grupo Number (PGN). 
As duas mensagens mandados pelo motor tem como Paramater Group Number PGN 0x088A e 0x098A respectivamente.

Com os bytes mais significativo do PGN (0x88 e 0x98) ficam dentra da faixa de [0x00-0xEF] o byte menos significativo do PGN indica o endereço de destino da mensagem. 
Neste caso o endereço de destino é 0x8A. 
Se o byte mais significiva do fosse entre a faixa de [0xF0 a 0xFF] a mensagem seria do tipo broadcast. 

Precisa-se ainda confirmar essa informação, pois eu não sei se o PGN é formado com a configuração big endian ou little endian, podendo ser 0x088A ou 0x8A08.
 
O PGN do J1939 especificam um dicionário de dados, para que se possa traduzir os bytes da mensagem em valores físicos do veículo por meio de DBC ou Database Can, também chamado de dicionário de dados.

## 3.3. Modulo de instrumentação

O módulo de instrumentação monitora a velocidade do veículo assim como controla o sistema de arrefeciento do veículo e o sistema do servo freio, assim com monitora outros subsistemas do veículo. 

O modulo de instrumentação está documentado em 
[`https://github.com/Tecnomobele-FGA/Modulo-instrumentacao`](https://github.com/Tecnomobele-FGA/Modulo-instrumentacao)

O link para a implementação do programa de controle está em 
[`https://github.com/rudivels/BREletrica_Sensor_CAN_Lcd_Velocidade_temperatura`](https://github.com/rudivels/BREletrica_Sensor_CAN_Lcd_Velocidade_temperatura)  

## 3.4. Módulo de Luzes

O módulo de luzes controle todos comandos de sinalização do painel e comanda as luzes a sinalização. 

O módulo está documentado em
 
[`https://github.com/Tecnomobele-FGA/Modulo-luzes`](https://github.com/Tecnomobele-FGA/Modulo-luzes)

O link pata a implementação do programa de controle está em 

[`https://github.com/rudivels/BREletrica_Luzes_CAN_beep_display`](https://github.com/rudivels/BREletrica_Luzes_CAN_beep_display)

## 3.5. BMS Battery Management System

O BMS é modelo EK-YT-21-BMS. 

A documentação se encontra no link 
[https://github.com/Tecnomobele-FGA/Banco-baterias](https://github.com/Tecnomobele-FGA/Banco-baterias)

O BMS é composto por 4 modulos de 16 celular LIFEPO4, ligado por meio de uma barramento próprio, passando alimentação e sinais para o modulo concentrador. Este modulo concentrador tem duas portas CAN. Uma porta para  o Battery Charger e outro avulso. 

Com o osciloscópio mediu-se o sinal no barramento CAN e descobriu-se que a velocidade de comunicação do barramento era de 250khz. 

Foi feito o teste em 14/05/2020 com Arduino e Can sheild da sparkfun. 
Ligou somente um modulo de batterias (tensão +-40 volts) e o display do BMS. 
Sem ligar o sparkfun o barramento mostra uma atividade muito intensa no osciloscópio. Assim que coloca o sparkfun, no barramento aparece somente um pacote de dados a cada 2 segundos.

Com o programa 
`CAN Read Demo for the SparkFun CAN Bus Shield.`
da biblioteca de CAN do Arduino Shield consegui ler o barramento. Configurou o programa para 250khz e a porta serial 57200 bps. 

Quando liga o concentrador somente com um modulo e o display e o Arduino CAN Shield.  

Testando com candump dia 04 junho 2020 ligando o BMS

```
breletrico@AcerNetbook:~$ candump can0 -c -tA -a
 (2020-06-04 13:35:16.779575)  can0  1806E5F4   [8]  09 99 00 0F 00 00 00 00   '........'
 (2020-06-04 13:35:16.782567)  can0  0CF1EFF4   [8]  00 00 00 00 00 00 00 00   '........'
 (2020-06-04 13:35:17.782563)  can0  1806E5F4   [8]  09 99 00 0F 00 00 00 00   '........'
 (2020-06-04 13:35:17.782604)  can0  0CF1EFF4   [8]  00 00 00 00 00 00 00 00   '........'
 (2020-06-04 13:35:18.782639)  can0  1806E5F4   [8]  09 99 00 0F 00 00 00 00   '........'
 (2020-06-04 13:35:18.782687)  can0  0CF1EFF4   [8]  00 00 00 00 00 00 00 00   '........'
 (2020-06-04 13:35:19.781635)  can0  1806E5F4   [8]  09 99 00 0F 00 00 00 00   '........'
 (2020-06-04 13:35:19.781682)  can0  0CF1EFF4   [8]  00 00 00 00 00 00 00 00   '........'
 (2020-06-04 13:35:20.780662)  can0  1806E5F4   [8]  09 99 00 0F 00 00 00 00   '........'
 (2020-06-04 13:35:20.784656)  can0  0CF1EFF4   [8]  00 00 00 00 00 00 00 00   '........'
 (2020-06-04 13:35:21.784668)  can0  1806E5F4   [8]  09 99 00 0F 00 00 00 00   '........'
 (2020-06-04 13:35:21.784720)  can0  0CF1EFF4   [8]  00 00 00 00 00 00 00 00   '........'
 (2020-06-04 13:35:22.783705)  can0  1806E5F4   [8]  09 99 00 0F 01 00 00 00   '........'
 (2020-06-04 13:35:22.783752)  can0  0CF1EFF4   [8]  00 00 00 00 00 00 00 00   '........'
 (2020-06-04 13:35:23.783718)  can0  1806E5F4   [8]  09 99 00 0F 01 00 00 00   '........'
 (2020-06-04 13:35:23.786722)  can0  0CF1EFF4   [8]  00 00 00 00 00 00 00 00   '........'
 (2020-06-04 13:35:24.786772)  can0  1806E5F4   [8]  09 99 00 0F 01 00 00 00   '........'
 (2020-06-04 13:35:24.786814)  can0  0CF1EFF4   [8]  00 00 00 00 00 00 00 00   '........'
```

Teste com timestamp e Chaveado a bateria on/off

`0x1806E5F4 = PDU Format 0x06, PDU Specific 0xE5, PGN = 1765, source adress = 0xF4`
`0x0CF1EFF4 = PDU Format 0xF1, PDU Specific 0xEF, PGN = 61935, source address = 0xF4`

Dá para concluir que o endereço de origem (Source Address) é 0xF4.
A primeira mensagem é destinada ao endereço 0xE5 enquanto a segunda mensagem é do tipo broadcast.

A descrição do protocolo J1939 do BMS está no [https://github.com/Tecnomobele-FGA/Banco-baterias](https://github.com/Tecnomobele-FGA/Banco-baterias)

# 4. Database CAN - DBC ou dicionário de dados

A partir da documentação dos dados de todos os equipamentos que estão ligados no barramento CAN podemos construimos um dicionário de dados DBC.

A montagem do DBC foi baseado no documento da CSS-Electronics [`https://www.csselectronics.com/screen/page/can-dbc-file-database-intro`](https://www.csselectronics.com/screen/page/can-dbc-file-database-intro)

Até o presente momento temos 5 ECU que vão ser interligados no barramento CAN.
Foi feito um ajuste para setar o primeiro bit do ID em 1.

Tabela com os ECU e seus ID.

| nome | ECU | Id mensagem | Id  (hex) |
|:-----|:---:|---:|---:|
| EVEC1 | Controlador motor elétrico Guandong | 2416544414 | 0x90098A9E |
| EVEC2 | Controlador motor elétrico Guandong | 2416478878 | 0x90088A9E |
| MODINSTRUM | Módulo de Instrumentação | 2432614288 | 0x90FEBF90 |
| BMS | BMS  (EK-YT-21-BMS)  | 2550588916| 0x9806E5F4 |
| CCS | Zepia TCCH-H233-10-C | 2566869221| 0x98FF50E5 |
| MODLUZ | Módulo de luzes e sinalização| |

O arquivo é  `BRELETmotorV3.dbc` na pasta `DBC`

```
VERSION ""

NS_ : 
    NS_DESC_
    CM_
    BA_DEF_
    BA_
    VAL_
    CAT_DEF_
    CAT_
    FILTER
    BA_DEF_DEF_
    EV_DATA_
    ENVVAR_DATA_
    SGTYPE_
    SGTYPE_VAL_
    BA_DEF_SGTYPE_
    BA_SGTYPE_
    SIG_TYPE_REF_
    VAL_TABLE_
    SIG_GROUP_
    SIG_VALTYPE_
    SIGTYPE_VALTYPE_
    BO_TX_BU_
    BA_DEF_REL_
    BA_REL_
    BA_DEF_DEF_REL_
    BU_SG_REL_
    BU_EV_REL_
    BU_BO_REL_
    SG_MUL_VAL_

BS_:

BU_:

BO_ 2432614288 MODINSTRUM: 8 Vector__XXX
 SG_ Velocity : 0|16@1+ (1,0) [0|200] "km/h" Vector__XXX

BO_ 2416544414 EVEC1: 8 Vector__XXX
 SG_ EngineSpeed : 0|16@1+ (1,0) [0|10000] "rpm" Vector__XXX
 SG_ Mileage     : 16|16@1+ (0.1,0) [0|300000] "km" Vector__XXX
 SG_ MotorTorque : 32|16@1+ (0.1,-1000) [-1000|1000] "Nm" Vector__XXX

BO_ 2416478878 EVEC2: 8 Vector__XXX
 SG_ Voltage : 0|16@1+ (0.1,-1000) [0|500] "v" Vector__XXX
 SG_ Current :16|16@1+ (0.1,-1000) [-500|500] "A" Vector__XXX
 SG_ Temperature :32|8@1+ (0.1,40) [0|100] "A" Vector__XXX
 SG_ Forward  :40|1@0+ (1,0) [0|0] "-" Vector__XXX
 SG_ Backward :41|1@0+ (1,0) [0|0] "-" Vector__XXX 
 SG_ Brake    :42|1@0+ (1,0) [0|0] "-" Vector__XXX 
 SG_ Stop     :43|1@0+ (1,0) [0|0] "-" Vector__XXX 
 SG_ Ready    :46|1@0+ (1,0) [0|0] "-" Vector__XXX  
 SG_ IGBT         :48|1@0+ (1,0) [0|0] "-" Vector__XXX 
 SG_ OverCurrent  :49|1@0+ (1,0) [0|0] "-" Vector__XXX 
 SG_ UnderVoltage :50|1@0+ (1,0) [0|0] "-" Vector__XXX  
 SG_ OverVoltage  :51|1@0+ (1,0) [0|0] "-" Vector__XXX  
 SG_ OverHeating  :52|1@0+ (1,0) [0|0] "-" Vector__XXX    
 SG_ OverSpeed    :53|1@0+ (1,0) [0|0] "-" Vector__XXX   
 SG_ BMS          :54|1@0+ (1,0) [0|0] "-" Vector__XXX 
 SG_ Error75g     :55|1@0+ (1,0) [0|0] "-" Vector__XXX     

BO_ 2550588916 BMS: 8 Vector__XXX
 SG_ MaxChargingVoltage :  0|16@1+ (0.1,0) [0|1000] "V" Vector__XXX
 SG_ MaxChargingCurrent : 16|16@1+ (0.1,0) [0|1000] "A" Vector__XXX
 SG_ ControlCharging  : 32|1@0 + (1,0) [0|0] "-" Vector__XXX
 
BO_ 2566869221 CCS: 8 Vector__XXX
 SG_ OutputVoltage :    0|16@1+ (0.1,0) [0|10000] "V" Vector__XXX
 SG_ OutputCurrent :   16|16@1+ (0.1,0) [0|10000] "A" Vector__XXX
 SG_ HardwareFailure      : 32|1@0 + (1,0)   [0|0] "-" Vector__XXX
 SG_ TemperatureOfCharger : 33|1@0 + (1,0)   [0|0] "-" Vector__XXX
 SG_ InputVoltage         : 34|1@0 + (1,0)   [0|0] "-" Vector__XXX
 SG_ StartingState        : 35|1@0 + (1,0)   [0|0] "-" Vector__XXX
 SG_ ComunicationState    : 36|1@0 + (1,0)   [0|0] "-" Vector__XXX

CM_ BO_ 2432614288 "Modulo de instrumentacao";
CM_ SG_ 2432614288 Velocity "Velocidade da roda dianteira ";
CM_ BO_ 2416544414 "Electric Vehicle Electronic Engine Controller 1";
CM_ SG_ 2416544414 EngineSpeed "Atual rotacao do motor electrico.";
CM_ SG_ 2416544414 Mileage "Atual quilometragem. ";
CM_ SG_ 2416544414 MotorTorque "Atual torque do motor. ";
CM_ BO_ 2416478878 "Electric Vehicle Electronic Engine Controller 2";
CM_ SG_ 2416478878 Voltage "Voltage of motor controller. ";
CM_ SG_ 2416478878 Current "Current of motor controller. ";
CM_ SG_ 2416478878 Temperature "Temperature of motor controller. ";
CM_ SG_ 2416478878 Forward "Estado do motor para frente. ";
CM_ SG_ 2416478878 Backward "Estado do motor para traz. ";
CM_ SG_ 2416478878 Brake "Estado do motor Freio. ";
CM_ SG_ 2416478878 Stop "Estado do motor Parada. ";
CM_ SG_ 2416478878 Ready "Estado do motor Pronto. ";
CM_ SG_ 2416478878 IGBT "Erro no IGBT. ";
CM_ SG_ 2416478878 OverCurrent "Erro de Sobre Corrente Overcurrent. ";
CM_ SG_ 2416478878 UnderVoltage "Erro de Sob tensao Undervoltage. ";
CM_ SG_ 2416478878 OverVoltage "Erro de Sobre tensao OverVoltage. ";
CM_ SG_ 2416478878 OverHeating "Erro de Sobre Temperatura OverHeating. ";
CM_ SG_ 2416478878 OverSpeed "Erro de Sobre Velocidade OverSpeed. ";
CM_ SG_ 2416478878 BMS "Erro de BMS. ";
CM_ SG_ 2416478878 Error75g "Erro de 75 graus Celsius. ";
CM_ BO_ 2550588916 "Battery Management System";
CM_ SG_ 2550588916 MaxChargingVoltage "Tensao maxima admisivel "; 
CM_ SG_ 2550588916 MaxChargingCurrent "Corrente maxima admisivel "; 
CM_ SG_ 2550588916 ControlCharging "controle charging 0=start 1=stop ";  
CM_ BO_ 2566869221 "Charger Controle System";
CM_ SG_ 2566869221 OutputVoltage "Tensao de saida. "; 
CM_ SG_ 2566869221 OutputCurrent "Corrente de saida. "; 
CM_ SG_ 2566869221 HardwareFailure  "0=normal 1=failure "; 
CM_ SG_ 2566869221 TemperatureOfCharger  "0=normal 1=Over temperature protection"; 
CM_ SG_ 2566869221 InputVoltage  "0=normal "; 
CM_ SG_ 2566869221 StartingState  "0=charger detects battery voltage and starts, 1=charges stays turned of (to prevent reverse polarity) "; 
CM_ SG_ 2566869221 ComunicationState  "0=communication is normal, 1=communication recieve time-out "; 

BA_DEF_ SG_  "SPN" INT 0 524287;
BA_DEF_ BO_  "VFrameFormat" ENUM  "StandardCAN","ExtendedCAN","reserved","J1939PG";
BA_DEF_  "DatabaseVersion" STRING ;
BA_DEF_  "BusType" STRING ;
BA_DEF_  "ProtocolType" STRING ;
BA_DEF_  "DatabaseCompiler" STRING ;
BA_DEF_DEF_  "SPN" 0;
BA_DEF_DEF_  "VFrameFormat" "J1939PG";
BA_DEF_DEF_  "DatabaseVersion" "";
BA_DEF_DEF_  "BusType" "";
BA_DEF_DEF_  "ProtocolType" "";
BA_DEF_DEF_  "DatabaseCompiler" "";
BA_ "ProtocolType" "J1939";
BA_ "BusType" "CAN";
BA_ "DatabaseCompiler" "Projeto BREletrico UnB";
BA_ "DatabaseVersion" "1.0.0";
BA_ "VFrameFormat" BO_ 2416544414 3;
BA_ "SPN" SG_ 2416544414 EngineSpeed 190;
BA_ "SPN" SG_ 2416478878 Voltage 84;
```

Tive que fazer uma adaptação no frame ID code de `0x10088A9E` ou `268995230`. 
Para que o CANTOOLS decodifica corretamente o código de 11 bits tivemos que mudar o frame para `0x90088A9E` ou seja, colocar um bit no primeiro bit da frame. Eu ainda não sei por que, mas deve ter a ver com o formato da frame.

Para conferir o DBC pode se usar o comando 
`$ cantools dump BRELETmotorV3.dbc` que gera automaticamente a estrutura do DBC.

## 4.1. Dicionário de dados do Modulo de instrumentação

Falta a informação do cycle time no DBC. 

```   ------------------------------------------------------------------------

  Name:       MODINSTRUM
  Id:         0x10febf90
      Priority:       4
      PGN:            0x0febf
      Source:         0x90
      Destination:    All
      Format:         PDU 2
  Length:     8 bytes
  Cycle time: - ms
  Senders:    -
  Layout:

                          Bit

             7   6   5   4   3   2   1   0
           +---+---+---+---+---+---+---+---+
         0 |------------------------------x|
           +---+---+---+---+---+---+---+---+
         1 |<------------------------------|
           +---+---+---+---+---+---+---+---+
             +-- Velocity
           +---+---+---+---+---+---+---+---+
     B   2 |   |   |   |   |   |   |   |   |
     y     +---+---+---+---+---+---+---+---+
     t   3 |   |   |   |   |   |   |   |   |
     e     +---+---+---+---+---+---+---+---+
         4 |   |   |   |   |   |   |   |   |
           +---+---+---+---+---+---+---+---+
         5 |   |   |   |   |   |   |   |   |
           +---+---+---+---+---+---+---+---+
         6 |   |   |   |   |   |   |   |   |
           +---+---+---+---+---+---+---+---+
         7 |   |   |   |   |   |   |   |   |
           +---+---+---+---+---+---+---+---+

  Signal tree:

    -- {root}
       +-- Velocity

  ------------------------------------------------------------------------
```

## 4.2. Dicionário de dados do Controlador do Motor
 
``` ------------------------------------------------------------------------

  Name:       EVEC1
  Id:         0x10098a9e
      Priority:       4
      PGN:            0x00900
      Source:         0x9e
      Destination:    0x8a
      Format:         PDU 1
  Length:     8 bytes
  Cycle time: - ms
  Senders:    -
  Layout:

                          Bit

             7   6   5   4   3   2   1   0
           +---+---+---+---+---+---+---+---+
         0 |------------------------------x|
           +---+---+---+---+---+---+---+---+
         1 |<------------------------------|
           +---+---+---+---+---+---+---+---+
             +-- EngineSpeed
           +---+---+---+---+---+---+---+---+
         2 |------------------------------x|
           +---+---+---+---+---+---+---+---+
     B   3 |<------------------------------|
     y     +---+---+---+---+---+---+---+---+
     t       +-- Mileage
     e     +---+---+---+---+---+---+---+---+
         4 |------------------------------x|
           +---+---+---+---+---+---+---+---+
         5 |<------------------------------|
           +---+---+---+---+---+---+---+---+
             +-- MotorTorque
           +---+---+---+---+---+---+---+---+
         6 |   |   |   |   |   |   |   |   |
           +---+---+---+---+---+---+---+---+
         7 |   |   |   |   |   |   |   |   |
           +---+---+---+---+---+---+---+---+

  Signal tree:

    -- {root}
       +-- EngineSpeed
       +-- Mileage
       +-- MotorTorque

  ------------------------------------------------------------------------

  Name:       EVEC2
  Id:         0x10088a9e
      Priority:       4
      PGN:            0x00800
      Source:         0x9e
      Destination:    0x8a
      Format:         PDU 1
  Length:     8 bytes
  Cycle time: - ms
  Senders:    -
  Layout:

                          Bit

             7   6   5   4   3   2   1   0
           +---+---+---+---+---+---+---+---+
         0 |------------------------------x|
           +---+---+---+---+---+---+---+---+
         1 |<------------------------------|
           +---+---+---+---+---+---+---+---+
             +-- Voltage
           +---+---+---+---+---+---+---+---+
         2 |------------------------------x|
           +---+---+---+---+---+---+---+---+
         3 |<------------------------------|
           +---+---+---+---+---+---+---+---+
             +-- Current
           +---+---+---+---+---+---+---+---+
         4 |<-----------------------------x|
           +---+---+---+---+---+---+---+---+
             +-- Temperature
           +---+---+---+---+---+---+---+---+
     B   5 |   |<-x|   |   |<-x|<-x|<-x|<-x|
     y     +---+---+---+---+---+---+---+---+
     t           |           |   |   |   +-- Forward
     e           |           |   |   +-- Backward
                 |           |   +-- Brake
                 |           +-- Stop
                 +-- Ready
           +---+---+---+---+---+---+---+---+
         6 |<-x|<-x|<-x|<-x|<-x|<-x|<-x|<-x|
           +---+---+---+---+---+---+---+---+
             |   |   |   |   |   |   |   +-- IGBT
             |   |   |   |   |   |   +-- OverCurrent
             |   |   |   |   |   +-- UnderVoltage
             |   |   |   |   +-- OverVoltage
             |   |   |   +-- OverHeating
             |   |   +-- OverSpeed
             |   +-- BMS
             +-- Error75g
           +---+---+---+---+---+---+---+---+
         7 |   |   |   |   |   |   |   |   |
           +---+---+---+---+---+---+---+---+

  Signal tree:

    -- {root}
       +-- Voltage
       +-- Current
       +-- Temperature
       +-- Ready
       +-- Stop
       +-- Brake
       +-- Backward
       +-- Forward
       +-- Error75g
       +-- BMS
       +-- OverSpeed
       +-- OverHeating
       +-- OverVoltage
       +-- UnderVoltage
       +-- OverCurrent
       +-- IGBT

  ------------------------------------------------------------------------

```

## 4.3. Dicionário de dados do BMS

```
  ------------------------------------------------------------------------

  Name:       BMS
  Id:         0x1806e5f4
      Priority:       6
      PGN:            0x00600
      Source:         0xf4
      Destination:    0xe5
      Format:         PDU 1
  Length:     8 bytes
  Cycle time: - ms
  Senders:    -
  Layout:

                          Bit

             7   6   5   4   3   2   1   0
           +---+---+---+---+---+---+---+---+
         0 |------------------------------x|
           +---+---+---+---+---+---+---+---+
         1 |<------------------------------|
           +---+---+---+---+---+---+---+---+
             +-- MaxChargingVoltage
           +---+---+---+---+---+---+---+---+
         2 |------------------------------x|
           +---+---+---+---+---+---+---+---+
     B   3 |<------------------------------|
     y     +---+---+---+---+---+---+---+---+
     t       +-- MaxChargingCurrent
     e     +---+---+---+---+---+---+---+---+
         4 |   |   |   |   |   |   |   |<-x|
           +---+---+---+---+---+---+---+---+
                                         +-- ControlCharging
           +---+---+---+---+---+---+---+---+
         5 |   |   |   |   |   |   |   |   |
           +---+---+---+---+---+---+---+---+
         6 |   |   |   |   |   |   |   |   |
           +---+---+---+---+---+---+---+---+
         7 |   |   |   |   |   |   |   |   |
           +---+---+---+---+---+---+---+---+

  Signal tree:

    -- {root}
       +-- MaxChargingVoltage
       +-- MaxChargingCurrent
       +-- ControlCharging

  ------------------------------------------------------------------------
```
## 4.4. Dicionário de dados Controlador de carga CCS

```
------------------------------------------------------------------------

  Name:       CCS
  Id:         0x18ff50e5
      Priority:       6
      PGN:            0x0ff50
      Source:         0xe5
      Destination:    All
      Format:         PDU 2
  Length:     8 bytes
  Cycle time: - ms
  Senders:    -
  Layout:

                          Bit

             7   6   5   4   3   2   1   0
           +---+---+---+---+---+---+---+---+
         0 |------------------------------x|
           +---+---+---+---+---+---+---+---+
         1 |<------------------------------|
           +---+---+---+---+---+---+---+---+
             +-- OutputVoltage
           +---+---+---+---+---+---+---+---+
         2 |------------------------------x|
           +---+---+---+---+---+---+---+---+
         3 |<------------------------------|
           +---+---+---+---+---+---+---+---+
     B       +-- OutputCurrent
     y     +---+---+---+---+---+---+---+---+
     t   4 |   |   |   |<-x|<-x|<-x|<-x|<-x|
     e     +---+---+---+---+---+---+---+---+
                         |   |   |   |   +-- HardwareFailure
                         |   |   |   +-- TemperatureOfCharger
                         |   |   +-- InputVoltage
                         |   +-- StartingState
                         +-- ComunicationState
           +---+---+---+---+---+---+---+---+
         5 |   |   |   |   |   |   |   |   |
           +---+---+---+---+---+---+---+---+
         6 |   |   |   |   |   |   |   |   |
           +---+---+---+---+---+---+---+---+
         7 |   |   |   |   |   |   |   |   |
           +---+---+---+---+---+---+---+---+

  Signal tree:

    -- {root}
       +-- OutputVoltage
       +-- OutputCurrent
       +-- ComunicationState
       +-- StartingState
       +-- InputVoltage
       +-- TemperatureOfCharger
       +-- HardwareFailure

  ------------------------------------------------------------------------

```

## 4.5. Dicionário de dados modulo de sinalização 

O módulo de sinalização vai ter o mesmo dicionário do motor EVEC2

```
  Name:       EVEC2
  Id:         0x10088a9e
      Priority:       4
      PGN:            0x00800
      Source:         0x9e
      Destination:    0x8a
      Format:         PDU 1
  Length:     8 bytes
  Cycle time: - ms
  Senders:    -
  Layout:

                          Bit

             7   6   5   4   3   2   1   0
           +---+---+---+---+---+---+---+---+
         0 |------------------------------x|
           +---+---+---+---+---+---+---+---+
         1 |<------------------------------|
           +---+---+---+---+---+---+---+---+
             +-- Voltage
           +---+---+---+---+---+---+---+---+
         2 |------------------------------x|
           +---+---+---+---+---+---+---+---+
         3 |<------------------------------|
           +---+---+---+---+---+---+---+---+
             +-- Current
           +---+---+---+---+---+---+---+---+
         4 |<-----------------------------x|
           +---+---+---+---+---+---+---+---+
             +-- Temperature
           +---+---+---+---+---+---+---+---+
     B   5 |   |<-x|   |   |<-x|<-x|<-x|<-x|
     y     +---+---+---+---+---+---+---+---+
     t           |           |   |   |   +-- Forward
     e           |           |   |   +-- Backward
                 |           |   +-- Brake
                 |           +-- Stop
                 +-- Ready
  -------------------------------------------------------------------
```

# 5. Python Cantools

A biblioteca CANTOOLS permite codificar e decodificar mensagens CAN por meio de arquivos DBC. [https://github.com/eerimoq/cantools](https://github.com/eerimoq/cantools)

A vantagem dessa aborfagem é que todo a informação das mensagens no barramento pode ser verificado com o arquivo DBC. 

Pode se de um lado usar o programa que simula o funcionamento do controlador do motor em python com a biblioteca do CANTOOLS, que está no `simulador_motor_cantools.py` no diretório `code_simulador_motor`

```
import can 
import cantools
from pprint import pprint

db = cantools.database.load_file('DBC/BRELETmotor.dbc') 
pprint(db.messages)
message1 = db.get_message_by_name('EVEC1')
message2 = db.get_message_by_name('EVEC2')

pprint (message1.signals)
pprint (message2.signals)

can_bus=can.interface.Bus(bustype='socketcan', channel='can0', bitrate=250000)

data = message1.encode({'EngineSpeed': 520, 'Mileage': 260, 'MotorTorque': 250})
mandou = can.Message(arbitration_id=message1.frame_id, data=data)
can_bus.send(mandou)

data = message2.encode({'Voltage': 300, 'Current': 260, 'Temperature': 50, 
  'Forward':1, 'Backward':1, 'Brake':1, 'Stop':1, 'Ready':1, 
  'IGBT':1, 'OverCurrent':1,'UnderVoltage':1,'OverVoltage':1,'OverHeating':1,
  'OverSpeed':1, 'BMS':1, 'Error75g':1
  })
mandou = can.Message(arbitration_id=message2.frame_id, data=data)
can_bus.send(mandou)

```

Do outro lado pode-se usar a mesma estrutura para decodificar os dados gerados pelo motor usando o DBC com um programa simples em Python `decoder.py`

```
import can 
import cantools
from pprint import pprint

print("Dados do DBC")
db = cantools.database.load_file('BRELETmotorV2.dbc')
pprint(db.messages)
m=db.get_message_by_name('MODINSTRUM')
pprint(m.signals)

print("Abrindo CAN1")
can_bus=can.interface.Bus(bustype='socketcan', channel='can1', bitrate=250000)

mensagem = can_bus.recv()
pprint(mensagem)
mm=db.decode_message(mensagem.arbitration_id, mensagem.data)
pprint(mm)
```

Este programa terá como saída 

```
$ python3 decoder.py 
Dados do DBC
[message('MODINSTRUM', 0x10febf90, True, 8, {None: 'Modulo de instrumentacao'}),
 message('EVEC1', 0x10098a9e, True, 8, {None: 'Electric Vehicle Electronic Engine Controller 1'}),
 message('EVEC2', 0x10088a9e, True, 8, {None: 'Electric Vehicle Electronic Engine Controller 2'})]
[signal('Velocity', 0, 16, 'little_endian', False, None, 1, 0, 0, 200, 'km/h', False, None, None, None, {None: 'Velocidade da roda dianteira '})]
Abrindo CAN1
can.Message(timestamp=1616048152.323884, arbitration_id=0x10febf90, extended_id=True, channel='can1', dlc=8, data=[0xa8, 0x2, 0xff, 0xff, 0xff, 0xff, 0xff, 0xff])
{'Velocity': 680}
debian@beaglebone:~/src/canbus$ 
```

As rotinas do `CANTOOLS` Python serão muito útil para analizar e fazer o processamento posterior do trafego no CAN.  

Tem diversas maneiras de visualizar os dados. 
Há a opção de plotar ou monitorar.

## 5.1 Cantools Monitor

Outra maneira de visualizar o dado no barramento CAN é pelo 
`python3 -m cantools monitor -c can0 -B 125000 src/DBC/BRELETmotorV2.dbc`

Para programação em Python Veja artigo de Bruno Oliveira 2017 - Aplicação rede CAN com BBB e Python <https://www.embarcados.com.br/can-com-beaglebone-black-e-python/>

Para o J1939 e PGN veja Borth TF. Analisando os Impactos do Uso do Protocolo Can FD em Aplicações Automotivas – Estudo de Caso. UNIVERSIDADE FEDERAL DO RIO GRANDE DO SUL, 2016.

# 6. Modbus no On Board Computer

O programa no computador de borde tem que ser mais que somente ler os dados do barramento CAN, mas também armazenar e visualiza-los.

Há duas modos de operação.

* Operação off-line (armazenando os dados do CAN num banco local)
* Operação on-line com o carro no dinamômetro e visualizando os dados usando ScadaBR 

Aqui será detalhada como os dados serão disponibilizados por meio do Modbus-IP para o ScadaBr do dinamômetro. 

No lado do OBC é implementando um cliente Modbus por meio da biblioteca python pyModbusTCP. 

Temos que fazer uma análise dos dados, de onde vem e quem vai usar, e ver se é necessário algum tipo de processamento.

Outra coisa importante é a taxa de amostragem (cycle time) de cada dado. 
O próprio protocolo J1939 define o cycle time para cada variavel. 

Eu ainda não sei como tratar a questão dos cycle time de uma forma estruturado no OBC.

Para implementar a leitura e filtragem das mensagens vamos usar a biblioteca `python-can` 

| Mensagem | Origem | 
|:---:|:---:|
| Painel de botoes no OBC | OBC |
| Tensao bateria de tração  | BMS ou MODINSTRUM  |
| Corrente bateria de tração  | BMS ou MODINSTRUM |  
| Velocidade de deslocamento  | MODNSTRUM | 
| Tensão da bateria auxiliar  | OBC |

## 6.1. CAN J1939 para Modbus-IP

O computador de bordo tem que implementar a ponte entre o CAN e o ScadaBR. 
Para isso os dados recebidos pelo CAN serão mapeados como registradores no MODBUS. 

O Modbus-IP do ScadaBR tem uma limitação de velocidade de leitura e transmissão de dados. Nosso caso vamos padronizar a atualização a uma frequencia de 3 vezes por segundo, uma taxa compatível com nossa capacidade de acompanhar o fenômeno. 

Caso se precisa de analisar o transiente, pode ser fazer a leitura diretamento do barranto CAN com outras ferramentas.

Ou seja, o datasource do ScadaBR é atualizada 3 vezes por segundo.

| Variavel | Origem | Modbus-IP | Tipo | 
|:---|:---|:---:|:----:|
| Velocity | MODINSTRUM | 10 | Holding Register | 
| Tensao bateria | MODINSTRUM | 11 | Holding Register |
| Corrente bateria | MODINSTRUM | 12 | Holding Register |
| chaves1 | OBC | 10  | Input status Bit |
| chaves2 | OBC | 11  | Input status Bit |  
| chaves3 | OBC | 12  | Input status Bit | 
| Led | OBC | 13  | Input coil Bit |  

O programa a seguir implementa a conversão dos dados recebidos pelo CAN para Modbu-IP.

```
#!/bin/python3
import can 
import cantools
from pyModbusTCP.server import ModbusServer, DataBank
from time import sleep
from random import uniform
from PainelObc import painel

print("Dados do DBC")
db = cantools.database.load_file('../DBC/BRELETmotorV2.dbc')
print("Abrindo CAN0")
can_bus=can.interface.Bus(bustype='socketcan', channel='can0', bitrate=125000)
print("Abrindo Modbus")
server = ModbusServer("192.168.1.5",5020, no_block=True)
input_reg_velocidade=10
input_reg_voltage=11
input_reg_current=12
input_status_chaves=10
Painel = painel()
voltage=0
velocidade=0
current=0

try:
    print("Iniciando server")
    server.start()
    print("Online")
    sleep(1)
    while True:
        sleep(0.01)
        Painel.read()
        DataBank.set_bits(input_status_chaves, [Painel.chave1, Painel.chave2, Painel.chave3])
        mensagem = can_bus.recv(0.0)
        if mensagem is not None :
            mm=db.decode_message(mensagem.arbitration_id, mensagem.data) 
            if mensagem.arbitration_id == db.get_message_by_name('MODINSTRUM').frame_id : 
                if 'Velocity' in mm :
                    velocidade=mm["Velocity"]
                    DataBank.set_words(input_reg_velocidade, [int(velocidade)])    
            if mensagem.arbitration_id == db.get_message_by_name('EVEC2').frame_id : 
                if 'Voltage' in mm :
                    voltage=mm["Voltage"]
                    DataBank.set_words(input_reg_voltage, [int(voltage)])
                if 'Current' in mm :
                    voltage=mm["Current"]
                    DataBank.set_words(input_reg_current, [int(current)])                                     
            print("can -> modbus= " + str(velocidade) + " km/h, " + str(voltage) + " V, "+ str(current) + " Amp, " + str([Painel.chave1, Painel.chave2, Painel.chave3]), end = '\r')

except:
     print("Shutting down")
     server.stop()
     print("Off line")
```

Este programa ainda é bastante lento e há como otimizar o processamento usando as funções de filtro da biblioteca can-tools ou ainda as funções da biblioteca CAN que possam ser executados pelo kernel e não com as rotinas em python. 

Este programa será testado primeiramente no GamaGolfe e depois no BREletrico, já que eles vão usar o mesmo hardware de instrumentação.

## 6.2. ScadaBR Dinamômetro

A primeira versão do diagrama de bloco da bancada de ensaios com o ScadaBR do dinamômetro é mostrado a seguir.

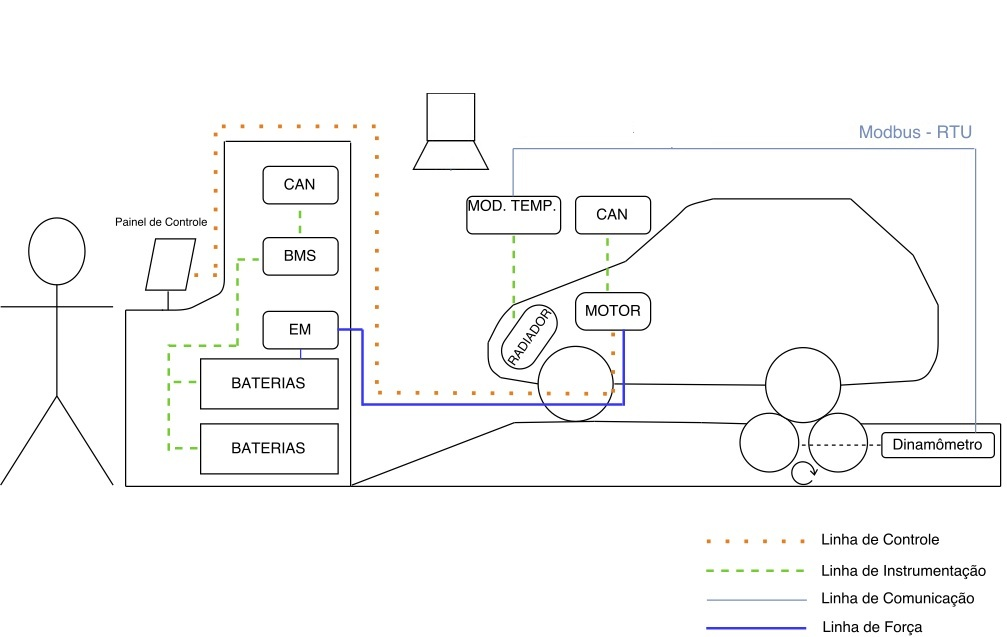
[picture p10: figuras/diagrama_dinamometro.jpg]


A tela sinótica do ScadaBR é mostrada a seguir.

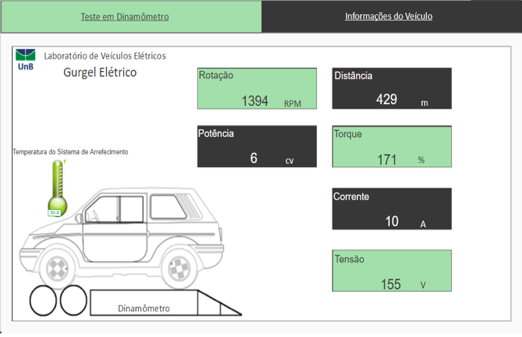
[picture p11: figuras/tela_sinotica_bancada.png]


## 6.3 Implementação dos ciclos NEDEC na bancada de ensaios

# 8. Comunicação entre processos

Até agora se elaborou no software do OBC como diversos partes independentes, mas para atender as necessidades devemos partir para sincronizar todos esses programas. 
Isto pode ser feito diretamente no código, fazendo um único programa monolítico, mas o desafio aqui é aproveitar todos os recursos do sistema operacional para fazer algo bastante portátil, modular e elegante. 

Faz se necessário criar um mecanismo de comunicação entre os diversos programas e vamos experimentar para usar o Inter Process Control `dbus` qque já vem no Linux e no python.

# Protocolo CANOPEN

O motor da WEG VVW500 usa Canopen @ 250000bps e identificação de 11bits.

# Bibliografia

Ribeiro A do N, Meneghin P, Els RH van. Developing technology for a Brazilian hybrid electric mini car. 2nd Lat. Am. Conf. Sustain. Dev. Energy, Water Environ. Syst., 2020, p. 1–10. 
[link artigo](http://fga.unb.br/rudi.van/galeria/arrigo-alex-lasdewes20-fp-161.pdf)

Borth TF. Analisando os Impactos do Uso do Protocolo Can FD em Aplicações Automotivas – Estudo de Caso. UNIVERSIDADE FEDERAL DO RIO GRANDE DO SUL, 2016.

[Volta](../README.md)

# Anexos 
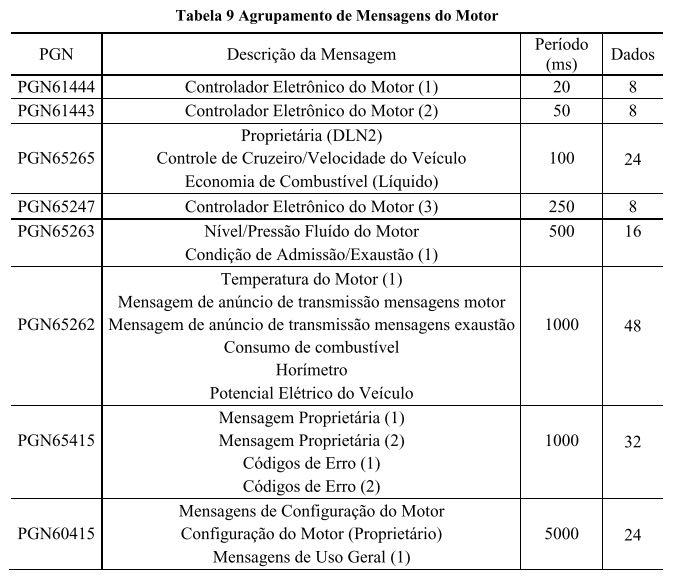
[picture p12: figuras/tab_pgn_01.jpg]


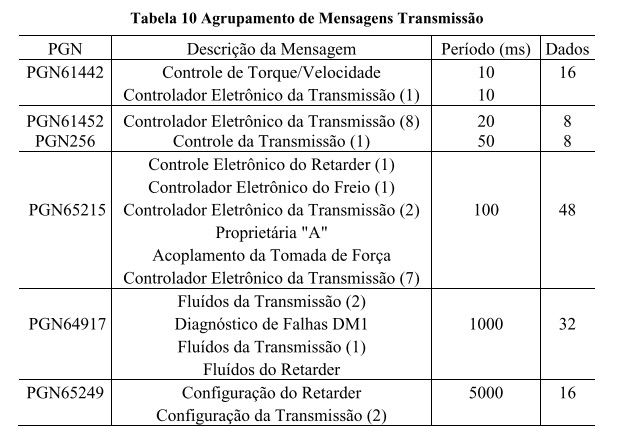
[picture p13: figuras/tab_pgn_02.jpg]


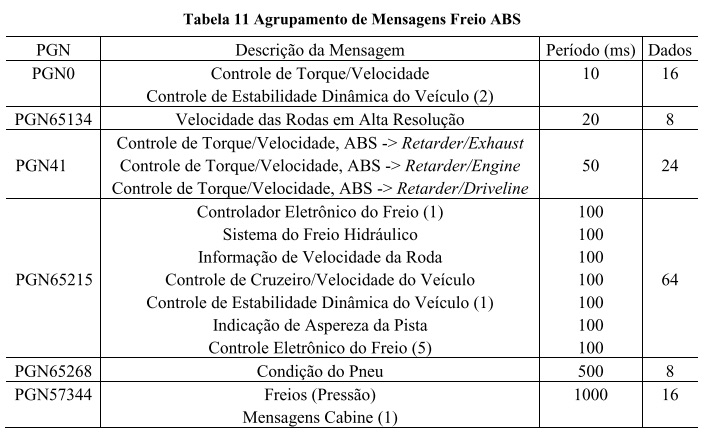
[picture p14: figuras/tab_pgn_03.jpg]


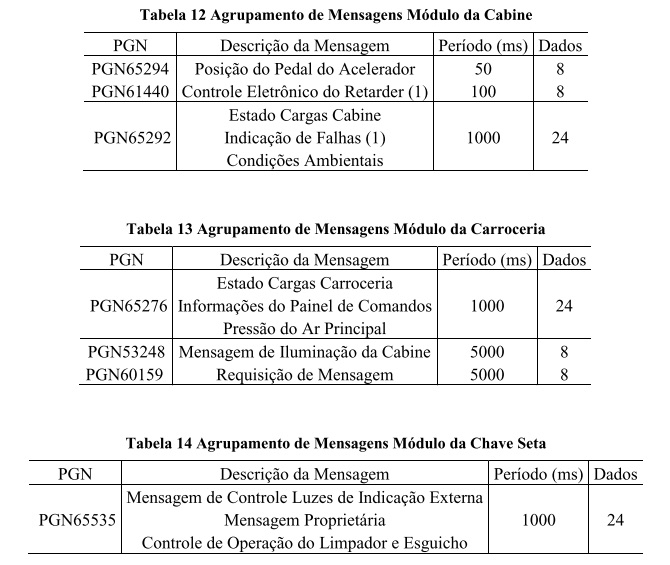
[picture p15: figuras/tab_pgn_04.jpg]


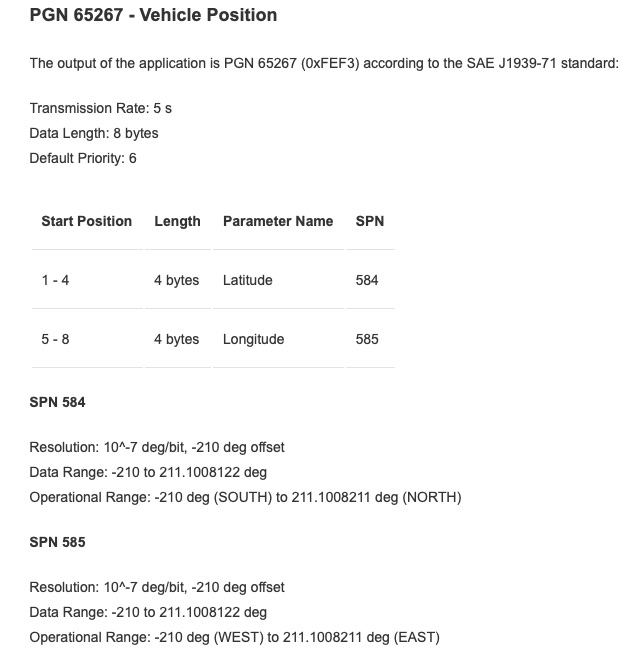
[picture p16: figuras/tab_pgn_gps.jpg]

[link J1939 GPS](https://copperhilltech.com/blog/sae-j1939-gps-application-with-arduino-due-delivers-pgn-65267-vehicle-position/)
