Tecnomobele-FGA/Computador-de-bordo/code/README.md

Códigos utilizados para testes de transmissão e recepção de rede CAN no BBB, rasp e arduino.
