Tecnomobele-FGA/Computador-de-bordo/figuras/Pinos_LoRa.jpg

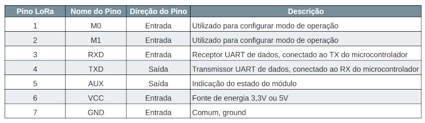
figuras/Pinos_LoRa.jpg
