Tecnomobele-FGA/Computador-de-bordo/fotos/Beagle_usb_dongle.jpg

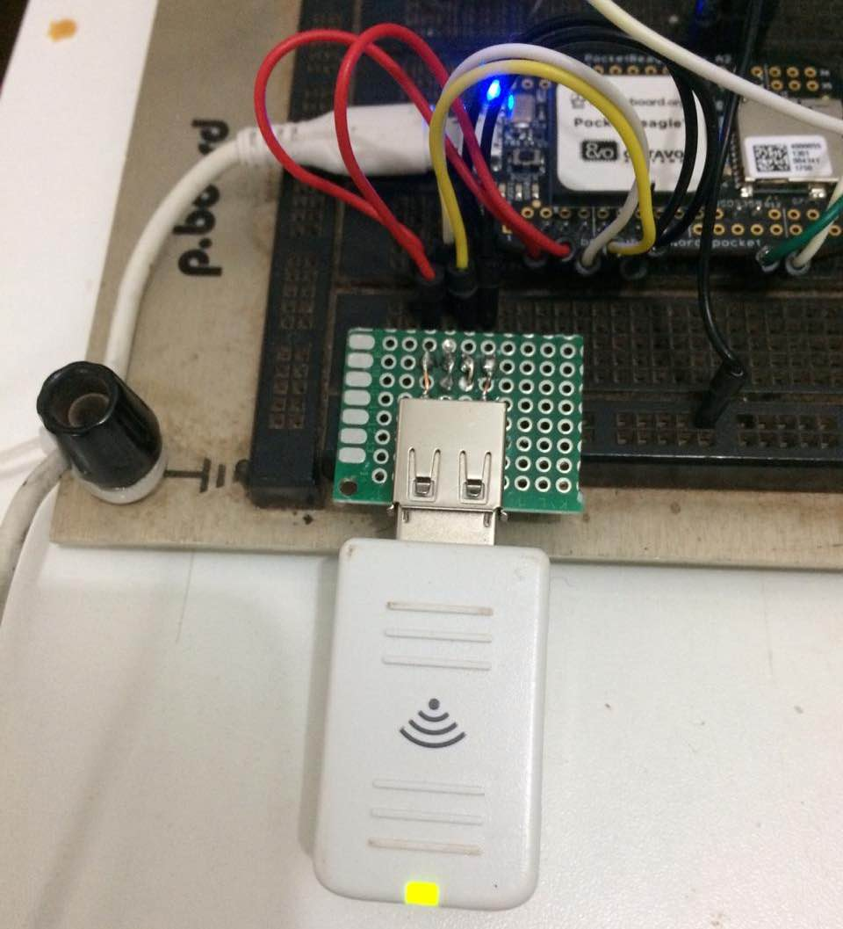
fotos/Beagle_usb_dongle.jpg
