Tecnomobele-FGA/Computador-de-bordo/fotos/modulo_radio_LoRa.jpg

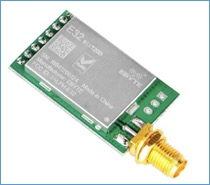
fotos/modulo_radio_LoRa.jpg
