Tecnomobele-FGA/Computador-de-bordo/(commit log)

2020-07-05 Create Receptor_can.c
    Código para teste de receptor CAN BUS no BBB/rasp
2020-07-05 Create transmissor_can.c
    Código exemplo de um transmissor CAN BUS no BBB/rasp
2020-07-05 Create rx_tx_CAN.ino
    Codigo receptor e transmissor de CAN BUS no arduino.
2020-07-05 Create can0_can1_start.sh
    Script para configurar e habilitar os pinos do BBB para o CAN.
2020-07-05 Create trasmissor_can.c
    codigo para teste de transmissor rede CAN no BBB/rasp
2020-07-05 Create receptor_can.c
    codigo teste de receptor CAN no BBB/rasp.
2020-07-05 Create rx_tx_CAN.ino
    código teste de receptor e transmissor de rede CAN no arduino.
2020-07-05 Create can0_can1_start.sh
    Script para configurar e habilitar os pinos de rede CAN no beaglebone.
2021-03-05 Organizando computador de bordo - simulador de motor
2021-03-11 Implementacao do CANTools em python e simulador do controlador do motor do BR800
2021-04-23 Atualizando com descrição do BMS
2021-07-05 Atualizando com mapa de uso das portas seriais (GPS e LoRa)
2021-09-17 Inclusão de bateria litium nobreak e GSM Sim800L
